sengbin/ChisFlash/BOM.md

# ChisFlash V1.0 BOM

| ID | Name | Designator | Footprint | Quantity | Manufacturer Part | Manufacturer | Supplier | Supplier Part |
| --- | --- | --- | --- | --- | --- | --- | --- | --- |
| 1 | S29GL256S10TFI010 | U2 | TSOP-56_L18.4-W14.0-P0.50-LS20.0-TL | 1 | S29GL256S10TFI010 | SPANSION | LCSC | C1350995 |
| 2 | FM28V100-TG | U4 | STSOP-32_L8.0-W11.8-P0.50-LS13.4-TL | 1 | FM28V100-TG | CYPRESS | LCSC | C2959453 |
| 3 | 100nF | C1,C2 | C0603 | 2 |  |  |  |  |
| 4 | NCD0603B1 | LED1 | LED0603-RD | 1 | NCD0603B1 |  | LCSC | C84266 |
| 5 | NCD0603G1 | LED2 | LED0603-RD | 1 | NCD0603G1 |  | LCSC | C84267 |
| 6 | 1kΩ | R1 | R0603 | 1 | 0603WAF1001T5E | UNI-ROYAL |  | C21190 |
| 7 | 10uF | C3 | C0603 | 1 | CL10A106MA8NRNC | SAMSUNG |  | C96446 |
| 8 | EPM240T100C5N | U5 | TQFP-100_L14.0-W14.0-P0.50-LS16.0-BL | 1 | EPM240T100C5N | Intel/Altera |  | C10041 |

# ChisFlash V0.1 BOM

- 替换FM28V100-TG为IS62LV1024LL-55H 
- Replace FM28V100-TG with IS62LV1024LL-55H
- 额外的2个10kΩ电阻，1个100kΩ电阻，2个1N4148WS二极管，1个1616电池
- Additional 2 10kΩ resistors, 1 100kΩ resistor, 2 1N4148WS diodes, 1 1616 battery
